Jahirul1404092/Water_quality-monitoring_and_controlling-_system/Report/figures/ConsumedWater.png

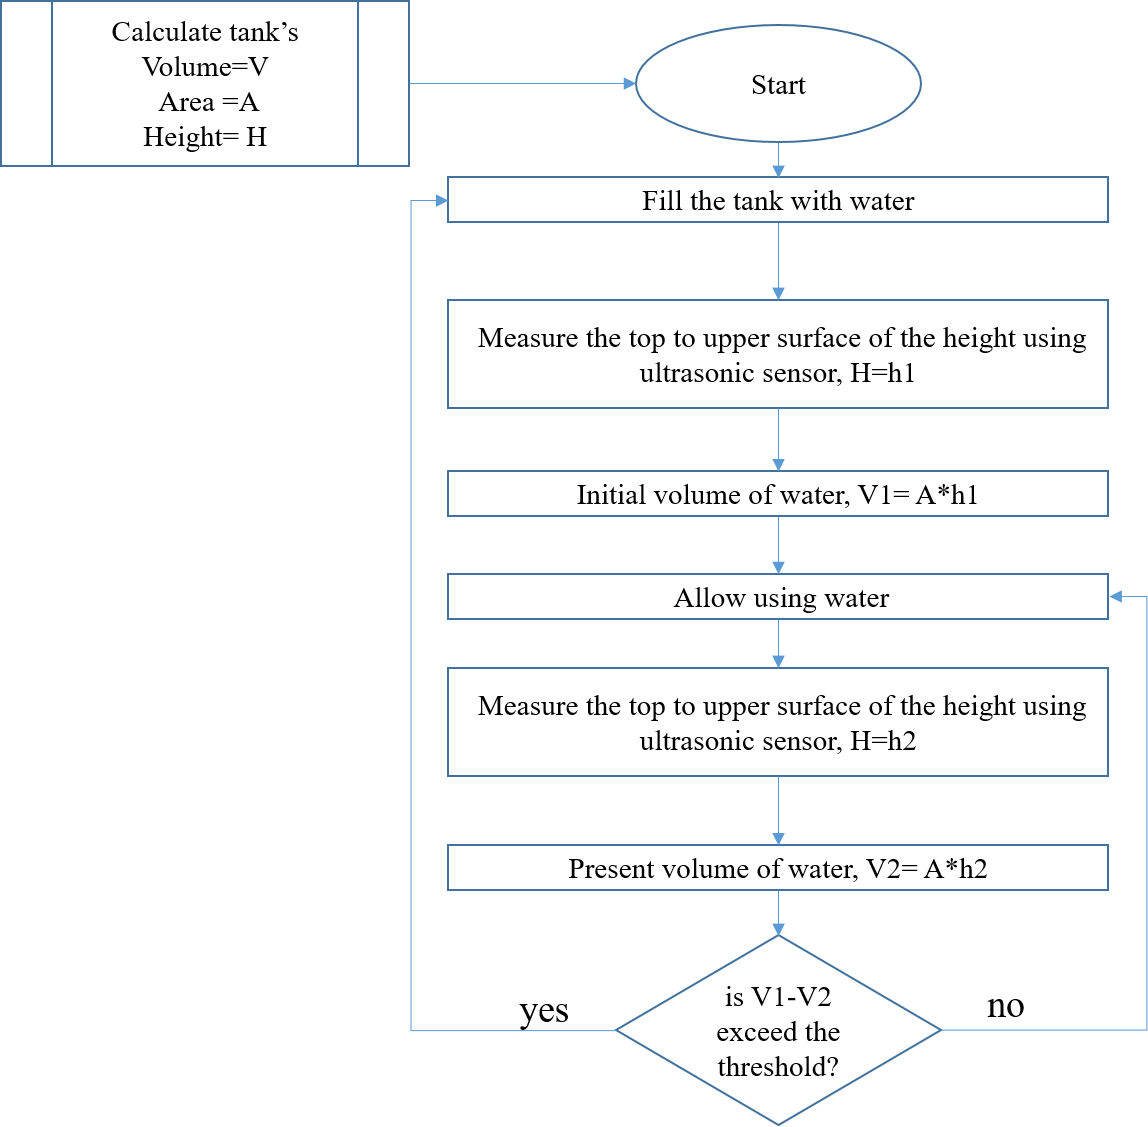
Report/figures/ConsumedWater.png
