Jahirul1404092/Water_quality-monitoring_and_controlling-_system/Report/figures/dirty2.jpg

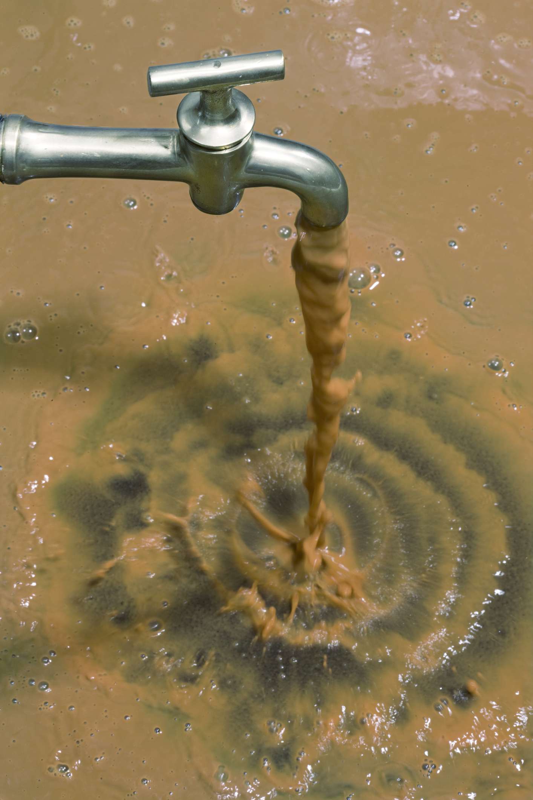
Report/figures/dirty2.jpg
