Jahirul1404092/Water_quality-monitoring_and_controlling-_system/Report/figures/display_bb.png

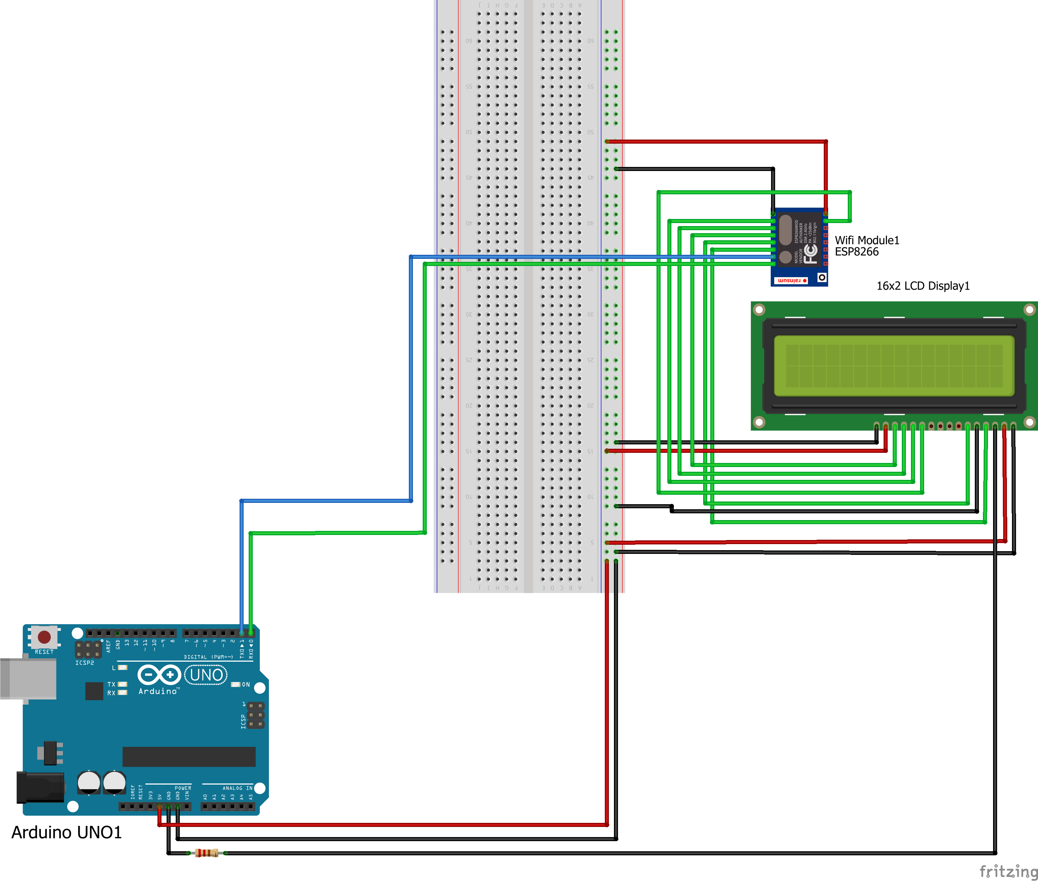
Report/figures/display_bb.png
