Jahirul1404092/Water_quality-monitoring_and_controlling-_system/Report/figures/flow chat.png

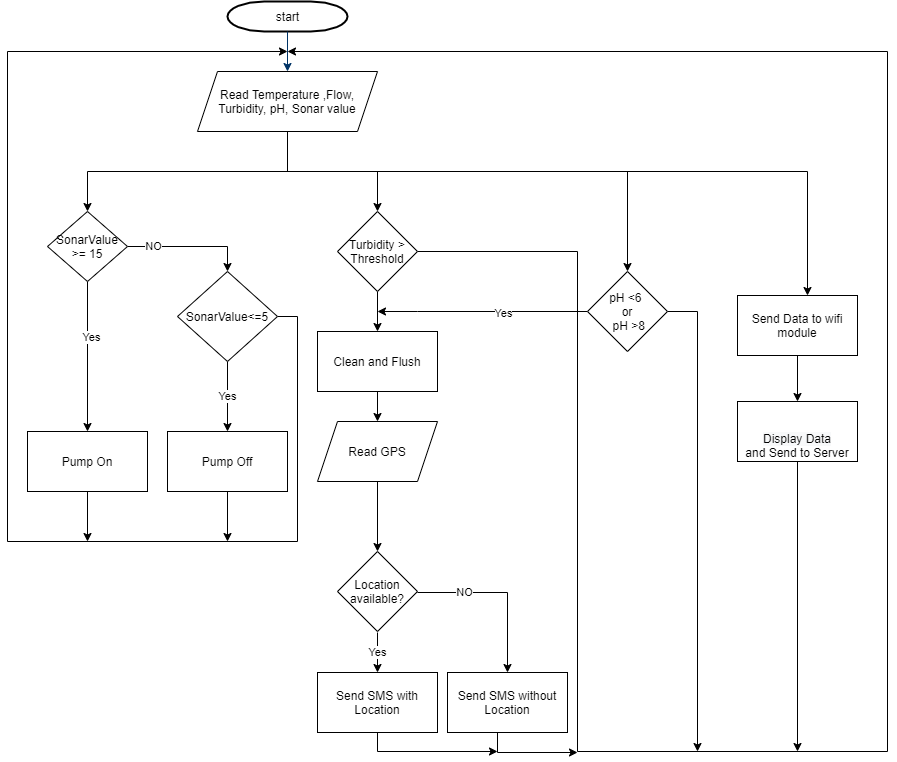
Report/figures/flow chat.png
