Jahirul1404092/Water_quality-monitoring_and_controlling-_system/Report/figures/qualityAssured.png

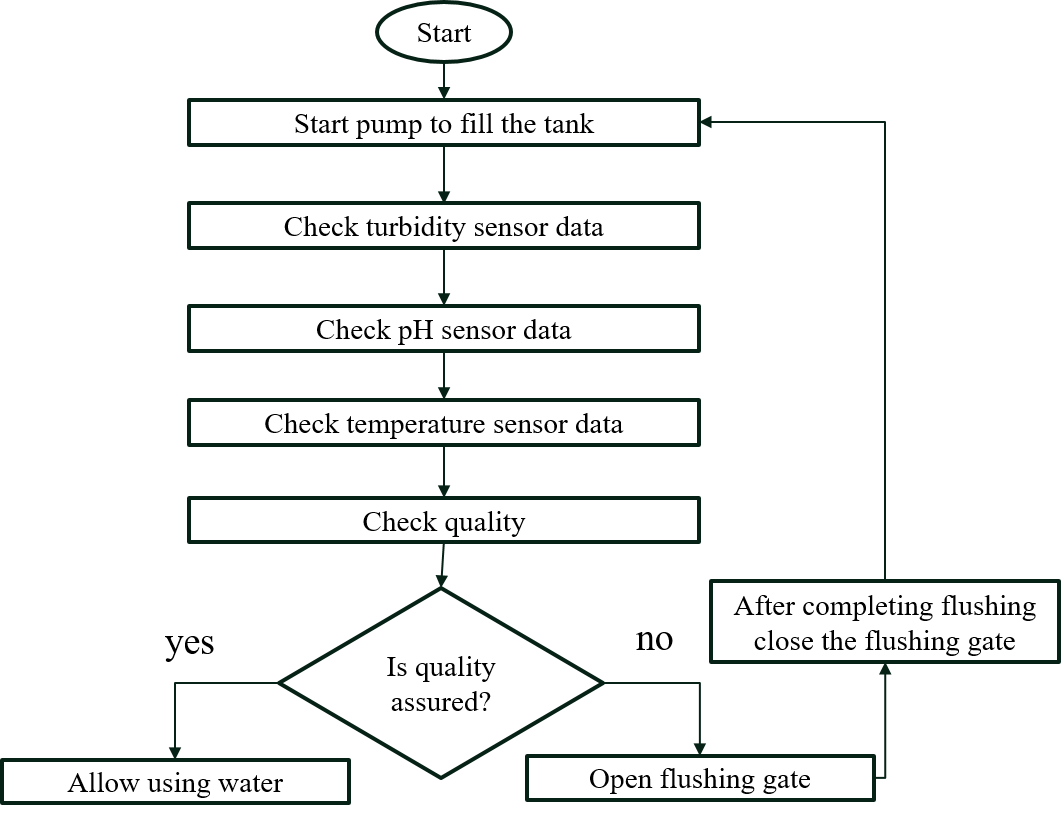
Report/figures/qualityAssured.png
