Jahirul1404092/Water_quality-monitoring_and_controlling-_system/Report/figures/Qualitybad.png

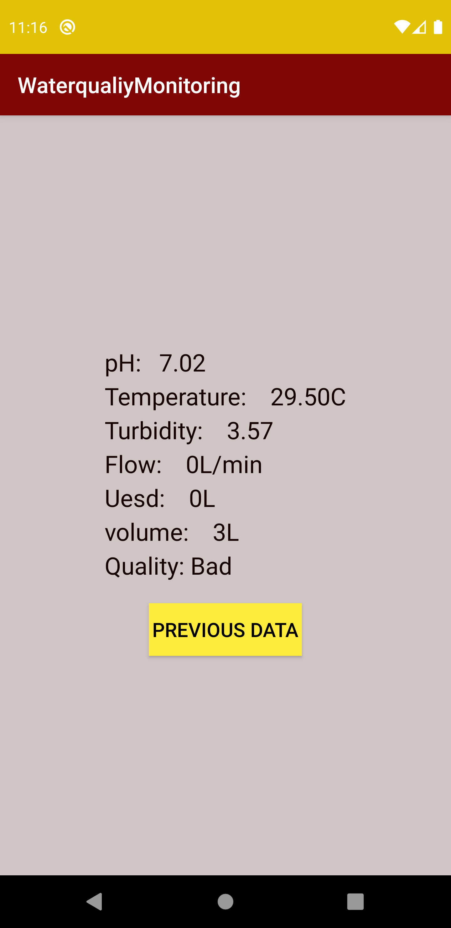
Report/figures/Qualitybad.png
