Jahirul1404092/Water_quality-monitoring_and_controlling-_system/Report/figures/tank.jpg

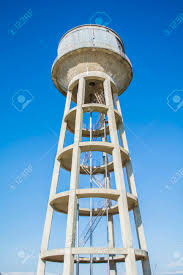
Report/figures/tank.jpg
