Jahirul1404092/Water_quality-monitoring_and_controlling-_system/Report/figures/flow chat.pdf

## Start

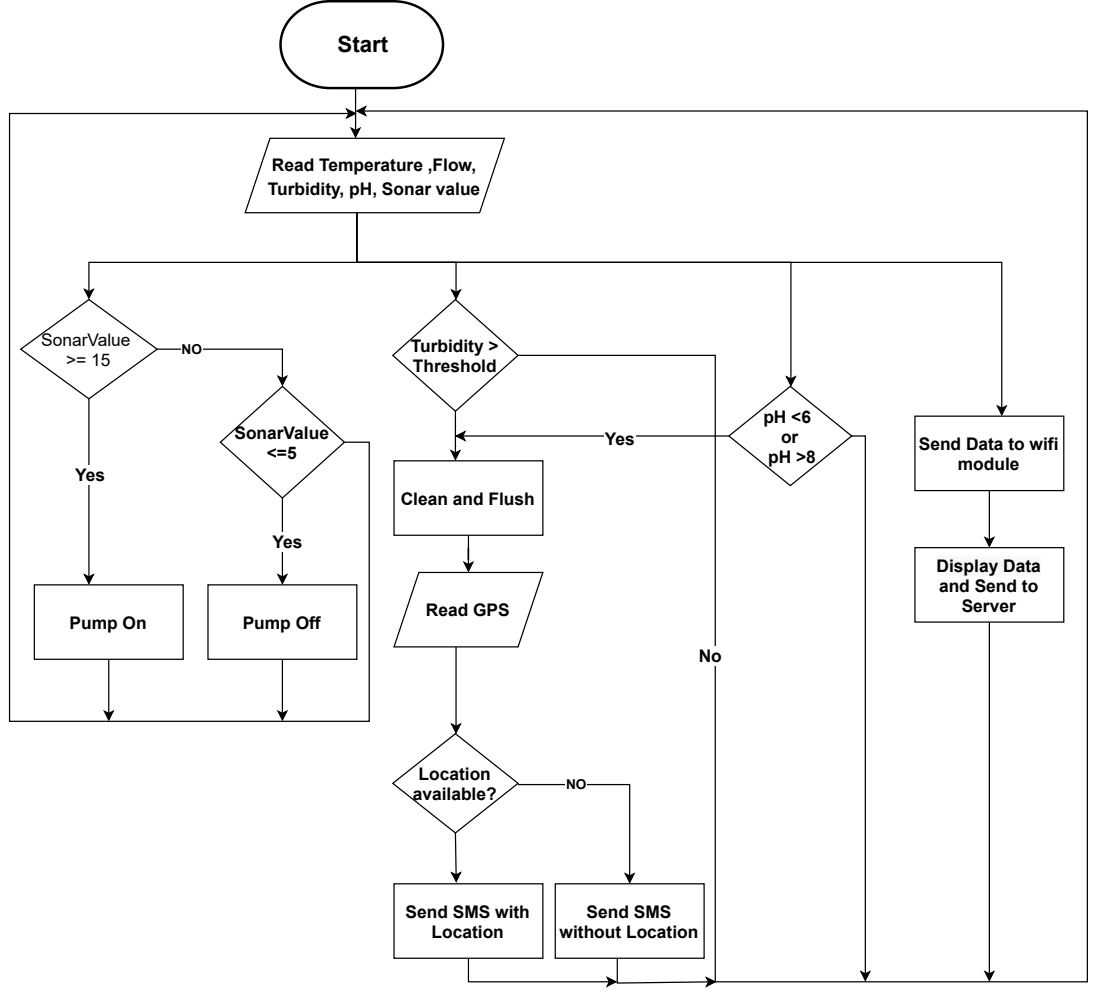
[picture p69: page 1]
Turbidity > Threshold; Yes; NO SonarValue >= 15; Pump On; SonarValue <=5; Pump Off; Read GPS; NO Location available?; Send SMS without Location

Read Temperature ,Flow,
Turbidity, pH, Sonar value

Send Data to wifi
module

Clean and Flush

Display Data
and Send to
Server

Send SMS with
Location
