Jahirul1404092/Water_quality-monitoring_and_controlling-_system/(commit log)

2021-07-31 Arduino code is added
2021-07-31 Servo code is added
2021-07-31 circuit diagram added
